barkingbunny/vodomer-teplomer/zadani-human.md

# Zadání: Vodomer-teplomer 
 ## obecne
 Tento projekt obsahuje skrizeni vice projektu. Jak Vodomer, tak teplomer.
 Deska PCB bude delana na miru, tedy bude se vytvaret. Hlavni cast desky bude procesor ktery ma wifi. 
 Doporucene jsou procesory jako ESP32, nebo rpi pico W, pripadne jiny procesor s wifi.  
 
 Deska ma umet merit prutok vody pomoci vodomeru, dle fotek a PN ve slozce doc. Mereni teploty se bude provadet dotykove na trubce teple vody, kde je odhalena nezaizolovana cast.

## Chování 
- 

## pozadavky
---- Mandatory ----
* wifi modul
* pripojeni ds18B20 - one wire
* ridici procesor typu stm32 c0 / G0
* meric indukce - civka pro sledovani vodomeru
------wish-------
* zigbee / bluetooth
* pripojeni NTC termistoru
* 1x rizeni zavirani / otevirani ventilu (napajeno ze site)
* 2x vstup digitalni - endstop
* reset tlacitko
* Open / close tlacitka
* LED indikace pro manualni ovladani
*
