barkingbunny/vodomer-teplomer/(commit log)

2026-10-09 Vodomer-teplomer FW 0.6.4: DS18B20 + deep sleep + ThingSpeak (ESP-IDF 6.1)
    Nizkoenergeticky teplomer na M5Stack Basic: mereni kazde 2 min, prevod
    behem spanku, buffer v RTC + LittleFS (30 dni), NTP s korekci driftu,
    odesilani na ThingSpeak 3x denne (na USB kazde 2 h), konfiguracni portal,
    displej na stisk tlacitka, vypnuti dvojhmatem A+C.
    [partitions.csv]
2026-10-09 Nastenka do docs/ (GitHub Pages) + odkaz v README
    Hlavni kopie merici stranky je ted tady; kopie v js-storage/home-temperature
    se docasne udrzuje a casem smaze.
2026-10-09 FW 0.6.6: M5.begin() jen kdyz je potreba displej, flash 80 MHz, opravy GPIO
    - probuzeni casovacem bez M5.begin(): inicializace LCD v M5GFX ceka 120 ms,
    IP5306 se obsluhuje vlastni instanci nad m5::In_I2C
    - backlightHold bez gpio_config (IDF 6 pin rezervuje, LEDC ho pak odmitne)
    - tlacitka B/C pred ctenim nastavit jako vstup (jinak cetla "stisknuto")
    - GPIO15 LOW pri Wi-Fi (delal M5.begin), flash 80 MHz DIO
2026-10-12 Provoz 9.-12. 10.: vydrz ~2,5-3 dny, powerbanka se vypina, drift 0
2026-10-12 Rozhodnuti: finalni deska na ESP32-C6-WROOM-1
2026-10-12 Decision log: modul ESP32-C6-WROOM-1 (porovnani rady C)
2026-10-17 FW 0.6.7: po vypnuti A+C zustat vypnuty (IP5306 zkouska zateze), zapnuti POWER + A
2026-10-17 Vyhodit .history (vnoreny repo) a lokalni KiCad soubory z repozitare
2026-10-19 Nastenka: zvetseny graf se zoomem, VDD a graf baterie, okna 4/10/16/22 h
    - klepnuti na graf teploty otevre zobrazeni pres celou obrazovku
    (chartjs-plugin-zoom + hammer.js z cdnjs se SRI): kolecko / pinch = zoom,
    tazeni = posun, Shift+tazeni = vyber, dvojklik / dvojity tap = vychozi vyrez,
    tlacitka Vychozi / Vse / Zavrit, osa Y se prizpusobi viditelnemu vyrezu
    - stav zarizeni: napeti VDD (field7, FW v2), odhad dalsiho odeslani;
    klepnuti na hodnotu baterie zobrazi graf VDD [mV] + baterie [%] v case
    s kritickym prahem 3000 mV
    - text varovani: posila 4x denne (4, 10, 16, 22 h), drive 3x (6, 14, 22 h)
2026-11-01 Nastenka treti: dve cidla v jednom kanalu (FW 2.7.0), hlavni odkaz v README
    Cidlo v kanalu 0 = field1, cidlo v kanalu 1 = field8. Status 2.7.0 se rozklada
    (FW, reset, samples, win, err, batt-low, extra, id0/id1), souhrn s ROM kody,
    historie odeslani. Starsi stranky (hlavni, dva_senzory) v README az za ni.
